nawotech/lil-lite-board/simulations/5V_LED switch.asc

B1: bi; I=abs(V(VLED,VDD)*Id(M1)+V(N003,VDD)*Ig(M1))
C1: cap; 10µ
C2: cap; 10µ
C3: cap; 10n
C4: cap; 100n
M1: pmos; RTL020P02
M2: nmos; 2N7002
R1: res; 10k
R3: res; 20k
R4: res; 47k
R5: res; 47k
RJA: res; 166
Tambient: voltage; 50
V1: voltage; 10
V2: voltage; PULSE(0 3.3 1m 10n 10n 10m)
Named nets: 0, VDD, VLED, VLED_EN, VLED_MONITOR
.tran 9m10m
