nawotech/lil-lite-board/lil-lite-board.kicad_pcb

## KiCad design lil-lite-board.kicad_pcb (2021-10-29)

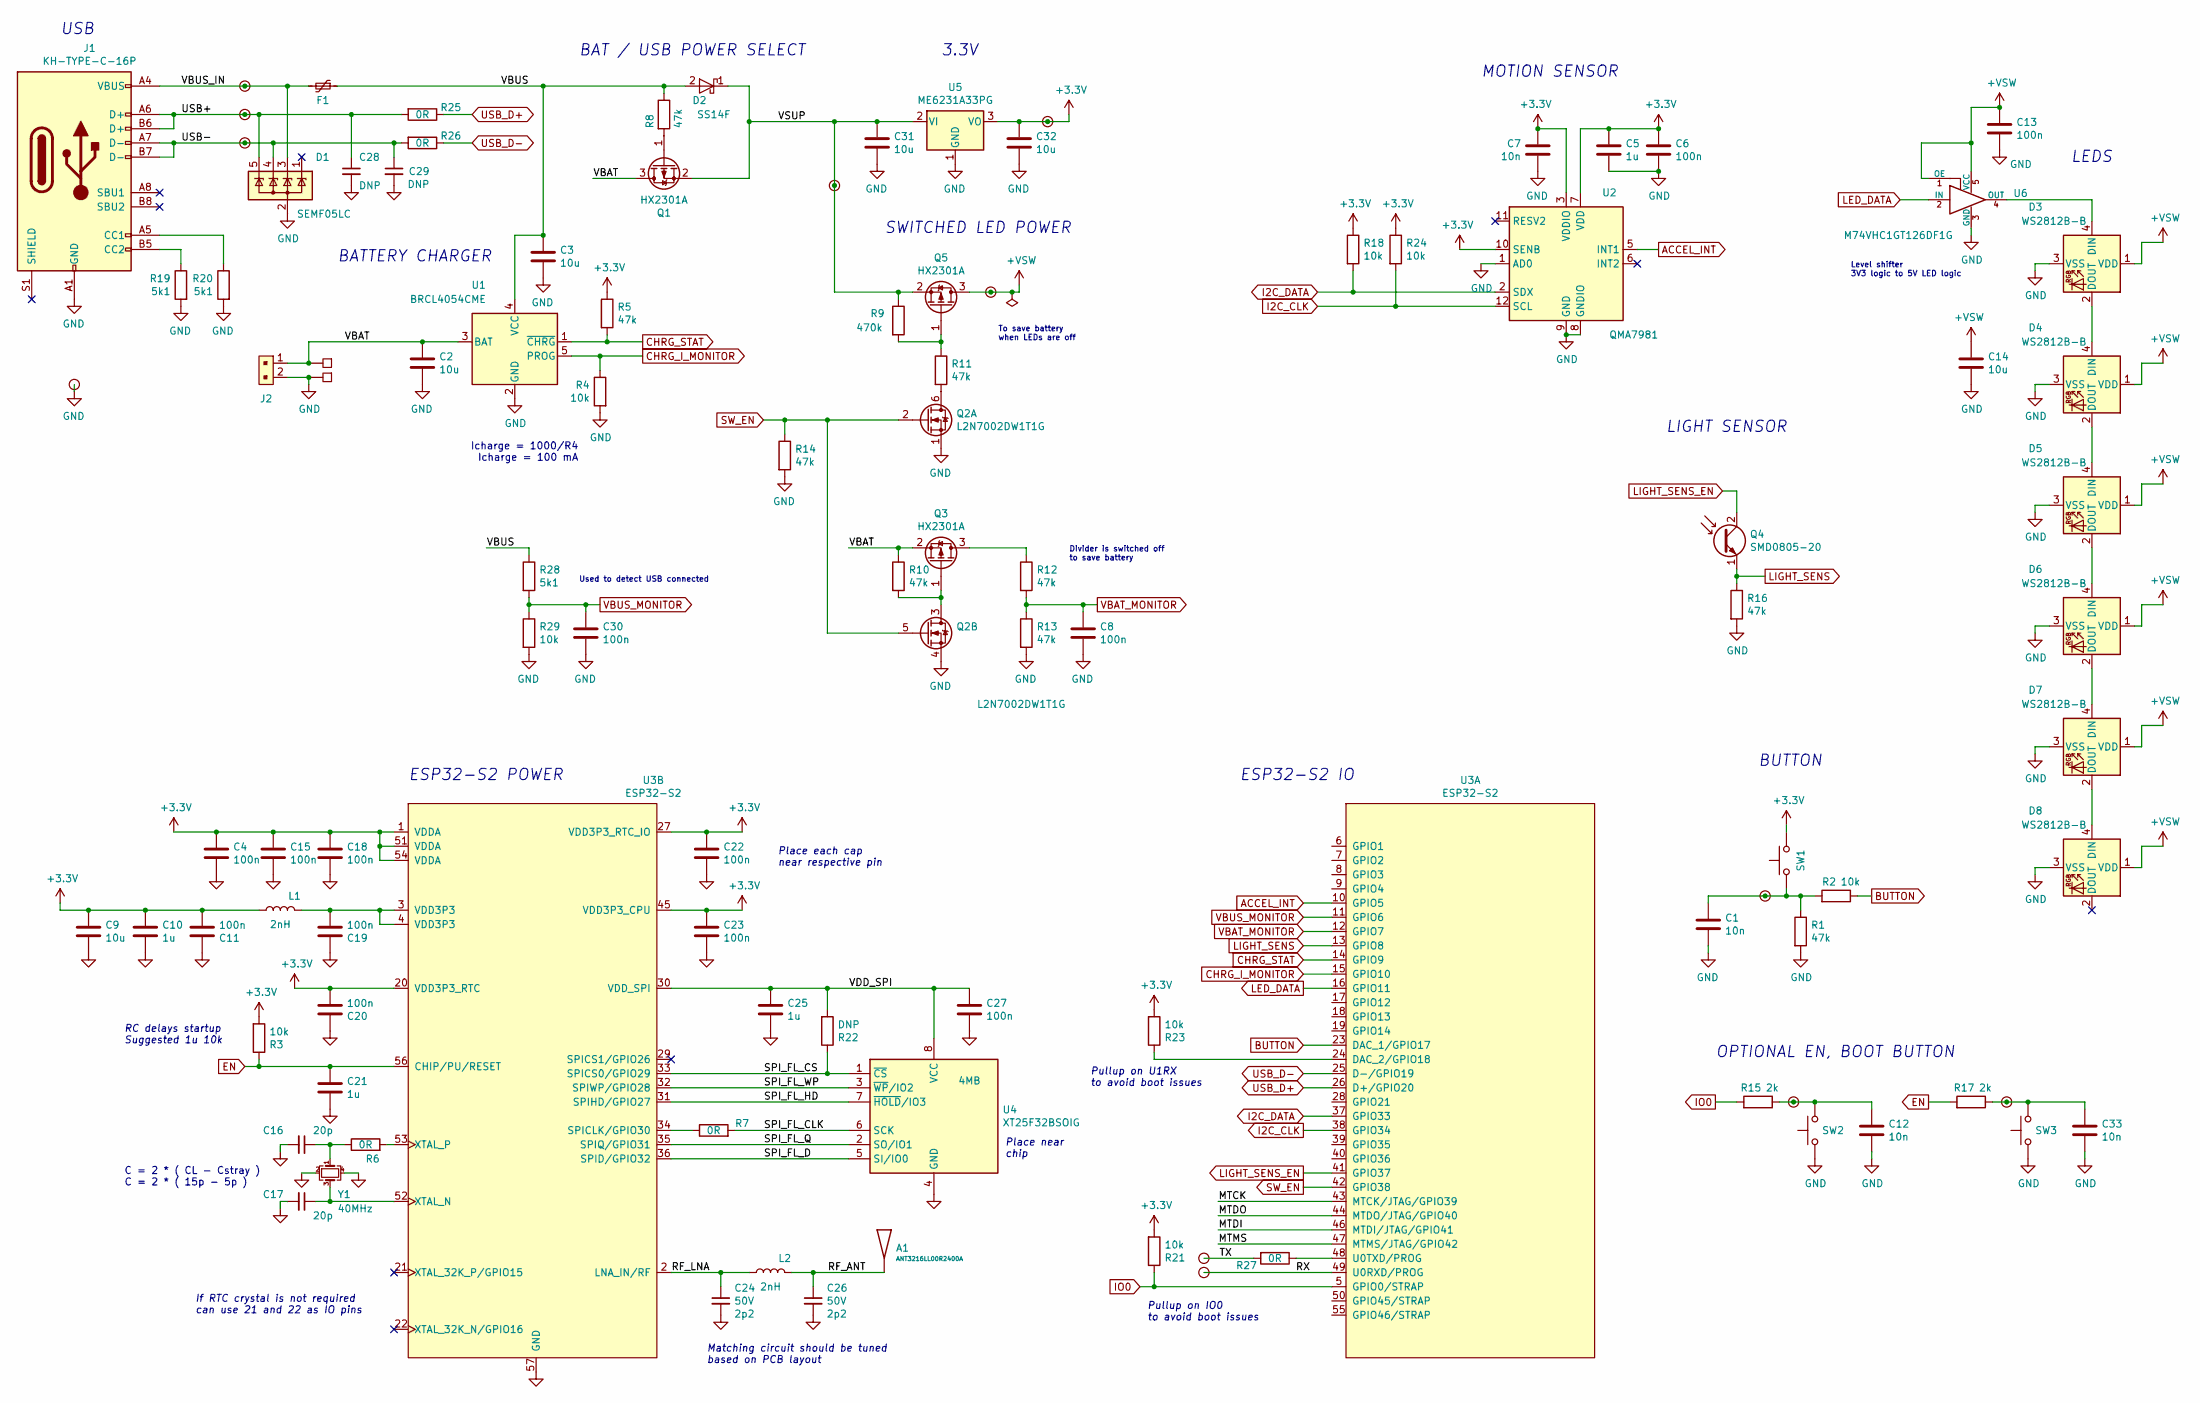
[picture p1: schematic lil-lite-board.sch, Lil Lite]

Parts:
A1: ANT3216LL00R2400A; Antenna_3216
C1, C7, C12, C33: 10n; C_0603_1608Metric; Voltage 100; LCSC Part Number C77439
C2, C3, C9, C14, C31, C32: 10u; C_0603_1608Metric; LCSC Part Number C319196
C4, C6, C8, C11, C13, C15, C18, C19, C20, C22, C23, C27, C30: 100n; C_0402_1005Metric; LCSC Part Number C60474
C5, C10, C21, C25: 1u; C_0402_1005Metric; LCSC Part Number C497333
C16, C17: C_0402_50V_COG_20p; C_0402_1005Metric; Voltage 50V
C24, C26: C_0402_50V_COG_2p2; C_0402_1005Metric; Voltage 50V
C28, C29: DNP; C_0402_1005Metric; Voltage 50V
D1: SEMF05LC; SOT-353_SC-70-5; LCSC Part Number C355236
D2: SS14F; D_SMA; LCSC Part Number C108832
D3, D4, D5, D6, D7, D8: WS2812B-B; LED_WS2812B_PLCC4_5.0x5.0mm_P3.2mm; LCSC Part Number C114586
F1: MF-FSMF050X-2; Fuse_0603_1608Metric; LCSC Part Number C210357
J1: KH-TYPE-C-16P; USB_C_Receptacle_KH-TYPE-C-16P
J2: S2B-PH-SM4-TB; PinHeader_2x1mm_P2mm_SMD_RA; MPN S2B-PH-SM4-TB(LF)(SN); Digi-Key_PN 455-1749-1-ND
L1, L2: HQ1005C2N0ST; L_0402_1005Metric
P2, P3: WirePad; Solder_Wire_Pad_5mmx3mm
Q1, Q3, Q5: HX2301A; SOT-23
Q2: L2N7002DW1T1G; SOT-363_SC-70-6
Q4: SMD0805-20; LED_0805_2012Metric; LCSC Part Number C250858
R1, R5, R8, R10, R11, R12, R13, R16: 47k; R_0402_1005Metric; LCSC Part Number C380741
R2, R3, R4, R18, R21, R23, R24: 10k; R_0402_1005Metric; LCSC Part Number C60490
R6, R7, R25, R26, R27: 0R; R_0402_1005Metric
R9: 470k; R_0402_1005Metric; LCSC Part Number C409715
R14: 47k; R_0402_1005Metric; Tolerance 1%
R15, R17: 2k; R_0402_1005Metric; LCSC Part Number C60490
R19, R20, R28: 5k1; R_0402_1005Metric
R22: DNP; R_0402_1005Metric
R29: 10k; R_0402_1005Metric
SW1: TS5220A; SW_SPST_TL3342
SW2, SW3: DNP; STO-060A16AB
TP5, TP6, TP7, TP8, TP9, TP10, TP11, TP12, TP14, TP17, TP18, TP19: TestPoint_ICT_1mm; ICT_TestPoint_Pad_D1.00mm
U1: BRCL4054CME; SOT-23-5; LCSC Part Number C305436
U2: QMA7981; LGA-12_2x2mm_P0.5mm
U3: ESP32-S2
U4: XT25F32BSOIG; SOIC-8_3.9x4.9mm_P1.27mm
U5: ME6231A33PG; SOT-89-3
U6: M74VHC1GT126DF1G; SOT-353_SC-70-5
Y1: X322540MPB4SI; Crystal_SMD_3225-4Pin_3.2x2.5mm

Connections:
+3V3: C4.1, C5.1, C6.1, C7.1, C9.1, C10.1, C11.2, C15.1, C18.1, C20.2, C22.1, C23.1, C32.1, L1.1, R3.2, R5.1, R18.1, R21.2, R23.2, R24.1, SW1.1, TP19.1, U2.3 (VDDIO), U2.7 (VDD), U2.10 (SENB), U3.1 (VDDA), U3.20 (VDD3P3_RTC), U3.27 (VDD3P3_RTC_IO), U3.45 (VDD3P3_CPU), U3.51 (VDDA), U3.54 (VDDA), U5.3 (VO)
+VSW: C13.1, C14.1, D3.1 (VDD), D4.1 (VDD), D5.1 (VDD), D6.1 (VDD), D7.1 (VDD), D8.1 (VDD), Q5.3 (D), TP18.1, U6.1 (OE), U6.5 (VCC)
/MTCK: U3.43 (MTCK/JTAG/GPIO39)
/MTDI: U3.46 (MTDI/JTAG/GPIO41)
/MTDO: U3.44 (MTDO/JTAG/GPIO40)
/MTMS: U3.47 (MTMS/JTAG/GPIO42)
/RF_ANT: A1.1, C26.1, L2.2
/RF_LNA: C24.1, L2.1, U3.2 (LNA_IN/RF)
/RX: TP11.1, U3.49 (U0RXD/PROG)
/SPI_FL_CLK: R7.2, U4.6 (SCK)
/SPI_FL_CS: R22.1, U3.33 (SPICS0/GPIO29), U4.1 (~CS)
/SPI_FL_D: U3.36 (SPID/GPIO32), U4.5 (SI/IO0)
/SPI_FL_HD: U3.31 (SPIHD/GPIO27), U4.7 (~HOLD~/IO3)
/SPI_FL_Q: U3.35 (SPIQ/GPIO31), U4.2 (SO/IO1)
/SPI_FL_WP: U3.32 (SPIWP/GPIO28), U4.3 (~WP~/IO2)
/TX: R27.2, TP10.1
/USB+: C28.1, D1.5 (K), J1.A6 (D+), J1.B6 (D+), R25.2, TP6.1
/USB-: C29.1, D1.4 (K), J1.A7 (D-), J1.B7 (D-), R26.2, TP7.1
/VBAT: C2.1, J2.1, P2.1, Q1.3 (D), Q3.2 (S), R10.1, U1.3 (BAT)
/VBUS: C3.1, D2.2 (A), F1.1, R8.1, R28.1, U1.4 (VCC)
/VBUS_IN: D1.3 (K), F1.2, J1.A4 (VBUS), J1.A9 (VBUS), J1.B4 (VBUS), J1.B9 (VBUS), TP9.1
/VDD_SPI: C25.1, C27.1, R22.2, U3.30 (VDD_SPI), U4.8 (VCC)
/VSUP: C31.1, D2.1 (K), Q1.2 (S), Q5.2 (S), R9.1, TP17.1, U5.2 (VI)
ACCEL_INT: U2.5 (INT1), U3.10 (GPIO5)
BUTTON: R2.1, U3.23 (DAC_1/GPIO17)
CHRG_I_MONITOR: R4.1, U1.5 (PROG), U3.15 (GPIO10)
CHRG_STAT: R5.2, U1.1 (~CHRG), U3.14 (GPIO9)
EN: C21.1, R3.1, R17.2, U3.56 (CHIP/PU/RESET)
GND: C1.2, C2.2, C3.2, C4.2, C5.2, C6.2, C7.2, C8.2, C9.2, C10.2, C11.1, C12.2, C13.2, C14.2, C15.2, C16.2, C17.2, C18.2, C19.1, C20.1, C21.2, C22.2, C23.2, C24.2, C25.2, C26.2, C27.2, C28.2, C29.2, C30.2, C31.2, C32.2, C33.2, D1.2 (A), D3.3 (VSS), D4.3 (VSS), D5.3 (VSS), D6.3 (VSS), D7.3 (VSS), D8.3 (VSS), J1.A1 (GND), J1.A12 (GND), J1.B1 (GND), J1.B12 (GND), J2.2, P3.1, Q2.1 (S), Q2.4 (S), R1.2, R4.2, R13.2, R14.2, R16.2, R19.2, R20.2, R29.2, SW2.1, SW3.1, TP5.1, U1.2 (GND), U2.1 (AD0), U2.8 (GNDIO), U2.9 (GND), U3.57 (GND), U4.4 (GND), U5.1 (GND), U6.3 (GND), Y1.2, Y1.4
I2C_CLK: R24.2, U2.12 (SCL), U3.38 (GPIO34)
I2C_DATA: R18.2, U2.2 (SDX), U3.37 (GPIO33)
IO0: R15.2, R21.1, U3.5 (GPIO0/STRAP)
LED_DATA: U3.16 (GPIO11), U6.2 (IN)
LIGHT_SENS: Q4.1 (E), R16.1, U3.13 (GPIO8)
LIGHT_SENS_EN: Q4.2 (C), U3.41 (GPIO37)
unnamed: C1.1, R1.1, R2.2, SW1.2, TP8.1
unnamed: C12.1, R15.1, SW2.2, TP14.1
unnamed: C16.1, R6.1, Y1.1
unnamed: C17.1, U3.52 (XTAL_N), Y1.3
unnamed: C19.2, L1.2, U3.3 (VDD3P3), U3.4 (VDD3P3)
unnamed: C33.1, R17.1, SW3.2, TP12.1
unnamed: D3.2 (DOUT), D4.4 (DIN)
unnamed: D3.4 (DIN), U6.4 (OUT)
unnamed: D4.2 (DOUT), D5.4 (DIN)
unnamed: D5.2 (DOUT), D6.4 (DIN)
unnamed: D6.2 (DOUT), D7.4 (DIN)
unnamed: D7.2 (DOUT), D8.4 (DIN)
unnamed: J1.A5 (CC1), R20.1
unnamed: J1.B5 (CC2), R19.1
unnamed: Q1.1 (G), R8.2
unnamed: Q2.3 (D), Q3.1 (G), R10.2
unnamed: Q2.6 (D), R11.2
unnamed: Q3.3 (D), R12.1
unnamed: Q5.1 (G), R9.2, R11.1
unnamed: R6.2, U3.53 (XTAL_P)
unnamed: R7.1, U3.34 (SPICLK/GPIO30)
unnamed: R23.1, U3.24 (DAC_2/GPIO18)
unnamed: R27.1, U3.48 (U0TXD/PROG)
SW_EN: Q2.2 (G), Q2.5 (G), R14.1, U3.42 (GPIO38)
USB_D+: R25.1, U3.26 (D+/GPIO20)
USB_D-: R26.1, U3.25 (D-/GPIO19)
VBAT_MONITOR: C8.1, R12.2, R13.1, U3.12 (GPIO7)
VBUS_MONITOR: C30.1, R28.2, R29.1, U3.11 (GPIO6)

Notes on the sheet:
RC delays startup Suggested 1u 10k
C = 2 * ( CL - Cstray ) C = 2 * ( 15p - 5p )
If RTC crystal is not required can use 21 and 22 as IO pins
Pullup on U1RX to avoid boot issues
Place near chip
LEDS
Matching circuit should be tuned based on PCB layout
Icharge = 1000/R4 Icharge = 100 mA
MOTION SENSOR
LIGHT SENSOR
BUTTON
Level shifter 3V3 logic to 5V LED logic
3.3V
SWITCHED LED POWER
To save battery when LEDs are off
Divider is switched off to save battery
Used to detect USB connected
BATTERY CHARGER
USB
ESP32-S2 POWER
ESP32-S2 IO
BAT / USB POWER SELECT
Place each cap near respective pin
OPTIONAL EN, BOOT BUTTON
Pullup on IO0 to avoid boot issues

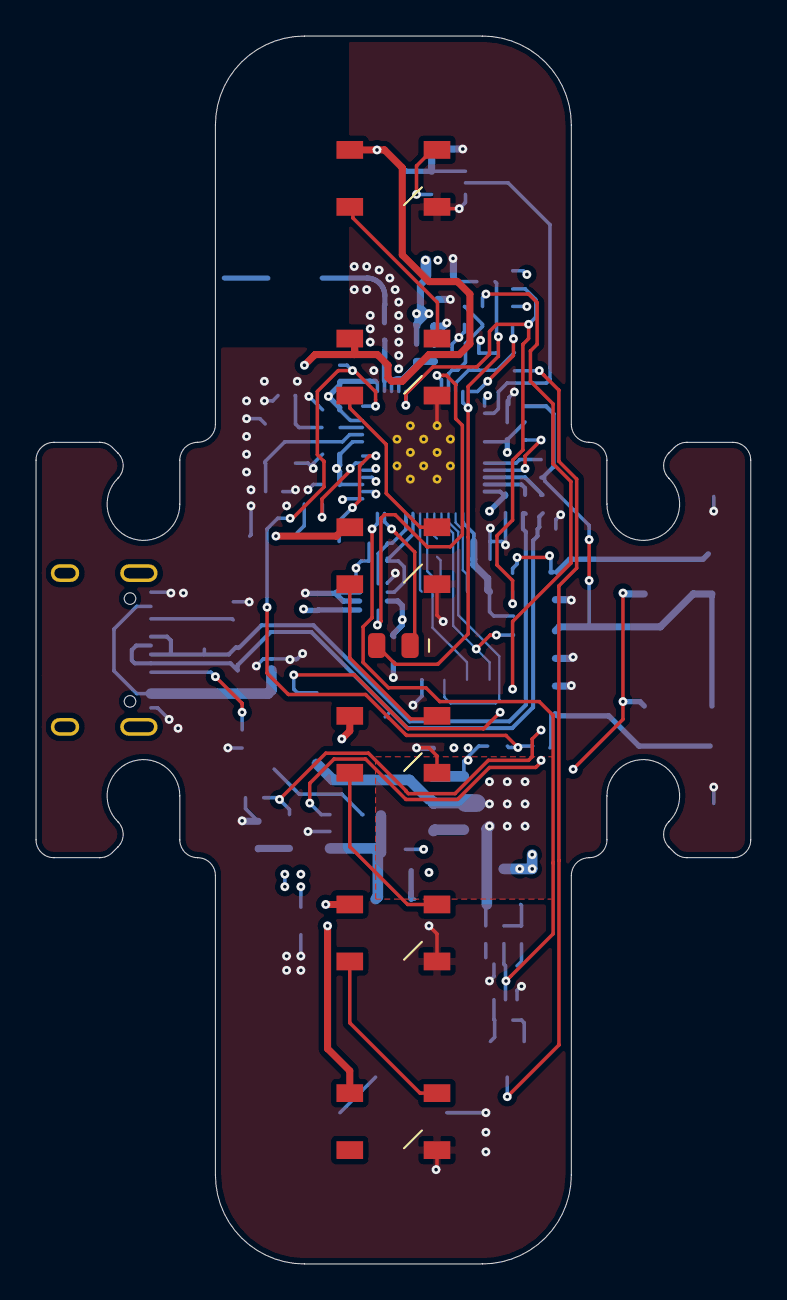
[picture p2: board lil-lite-board.kicad_pcb from above]

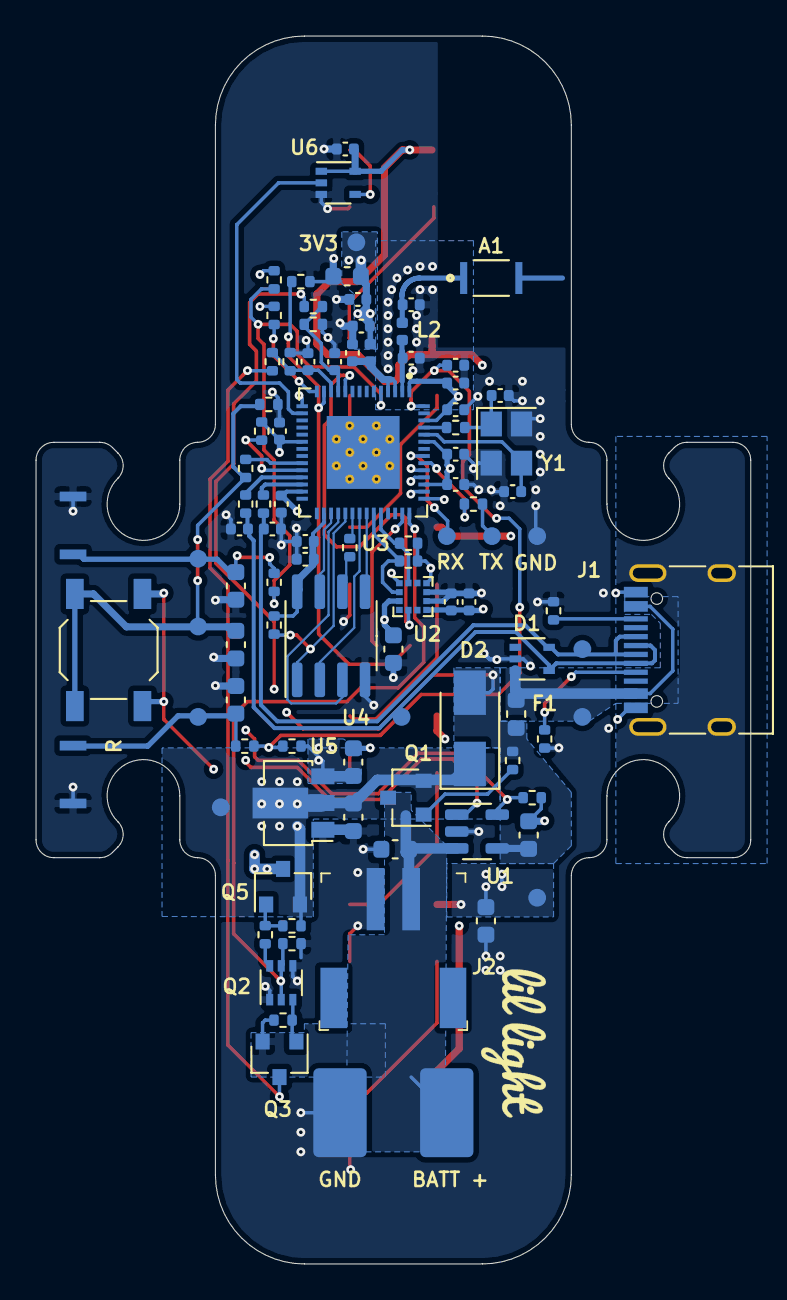
[picture p3: board lil-lite-board.kicad_pcb from below]

Board: 4 copper layers, 40.2 x 69.0 mm, 106 parts (99 on the bottom side), 59 nets.

Other parts of the board:
LG3: LOGO; Logo_Lil_Light_Long
