nawotech/lil-lite-board/(commit log)

2020-04-05 update logo and BOM
    [bike-light-board.kicad_pcb]
2020-04-15 add schematic pdf
    [bike-light-board.kicad_pcb, bike-light-board.sch]
2020-05-06 update assemby drawing layer
    [bike-light-board.kicad_pcb]
2020-05-06 remove front led caps
    [bike-light-board.kicad_pcb, bike-light-board.sch]
2020-05-06 update 3d models
    [bike-light-board.kicad_pcb]
2020-05-06 remove old v1 files
    [bike-light-board-B_Cu.gbl, bike-light-board-B_Mask.gbs, bike-light-board-B_Paste.gbp, bike-light-board-B_SilkS.gbo, bike-light-board-Edge_Cuts.gm1, bike-light-board-F_Cu.gtl, bike-light-board-F_Mask.gts, bike-light-board-F_Paste.gtp]
2021-01-09 update broken library
    [bike-light-board.kicad_pcb, bike-light-board.sch]
2021-07-20 update board
    [bike-light-board.kicad_pcb]
2021-07-26 update to esp32-s2
    [bike-light-board.sch]
2021-07-29 more updates
    [bike-light-board.kicad_pcb, bike-light-board.sch]
2021-08-01 clean up schematic
    [bike-light-board.kicad_pcb, bike-light-board.sch]
2021-08-07 routing done
    [bike-light-board.kicad_pcb, bike-light-board.sch]
2021-08-07 fix slkscreen
    [bike-light-board.kicad_pcb]
2021-08-07 Update BOM
    [bike-light-board.kicad_pcb, bike-light-board.sch]
2021-08-08 update schematic title block
    [bike-light-board.kicad_pcb, bike-light-board.sch]
2021-08-29 update flash chip to 4MB and divider for VBUS
    [bike-light-board.sch]
2021-09-29 update flash chip to faster version
    [bike-light-board.kicad_pcb, bike-light-board.sch]
2021-10-05 add sw pn
    [bike-light-board.sch]
2021-10-06 remove fab files
    [bike-light-board-CmtUser.gbr, bike-light-board-CuBottom.gbr, bike-light-board-CuTop.gbr, bike-light-board-EdgeCuts.gbr, bike-light-board-MaskBottom.gbr, bike-light-board-MaskTop.gbr, bike-light-board-PasteBottom.gbr, bike-light-board-PasteTop.gbr]
2021-10-14 update JCLPCB part numbers
    [bike-light-board.sch]
2021-10-14 add 10k to IO0 pin to fix boot issue
    [bike-light-board.kicad_pcb, bike-light-board.sch]
2021-10-18 update file names
    [lil-lite-board.kicad_pcb, lil-lite-board.sch]
2021-10-25 Change VBUS divider for digital in
    [lil-lite-board.sch]
2021-10-29 remove via in pad from dfm
    [lil-lite-board.kicad_pcb]
